UVicFormulaMotorsport/CANmon/hardware/documentation/models/c-1825910-7-c-3d.stp

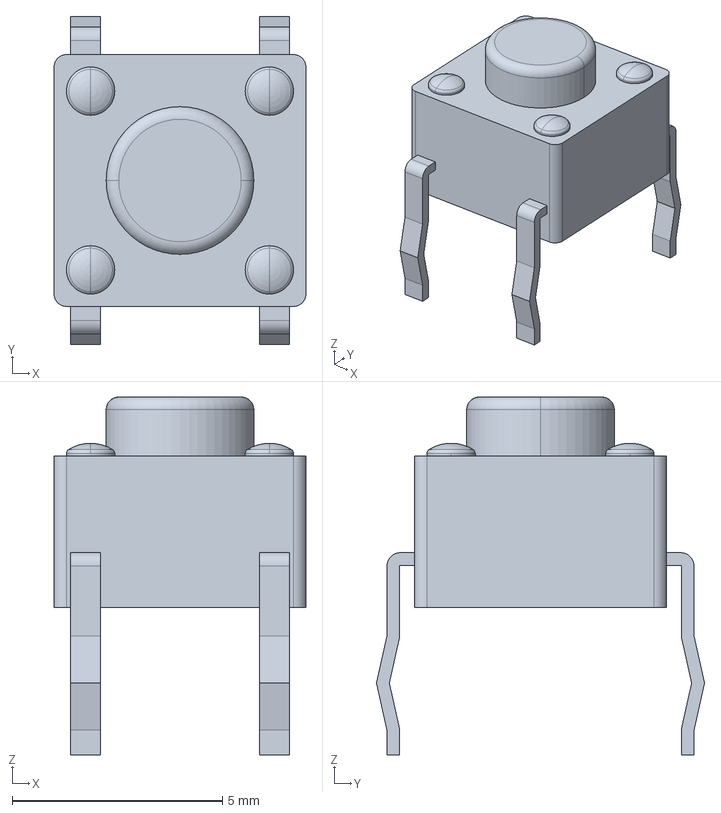
[picture p1: CAD file, 2016-02-04]
hardware/documentation/models/c-1825910-7-c-3d.stp
5.99 x 7.80 x 8.51 mm
