UVicFormulaMotorsport/CANmon/hardware/release/CANmon_Schematic.pdf

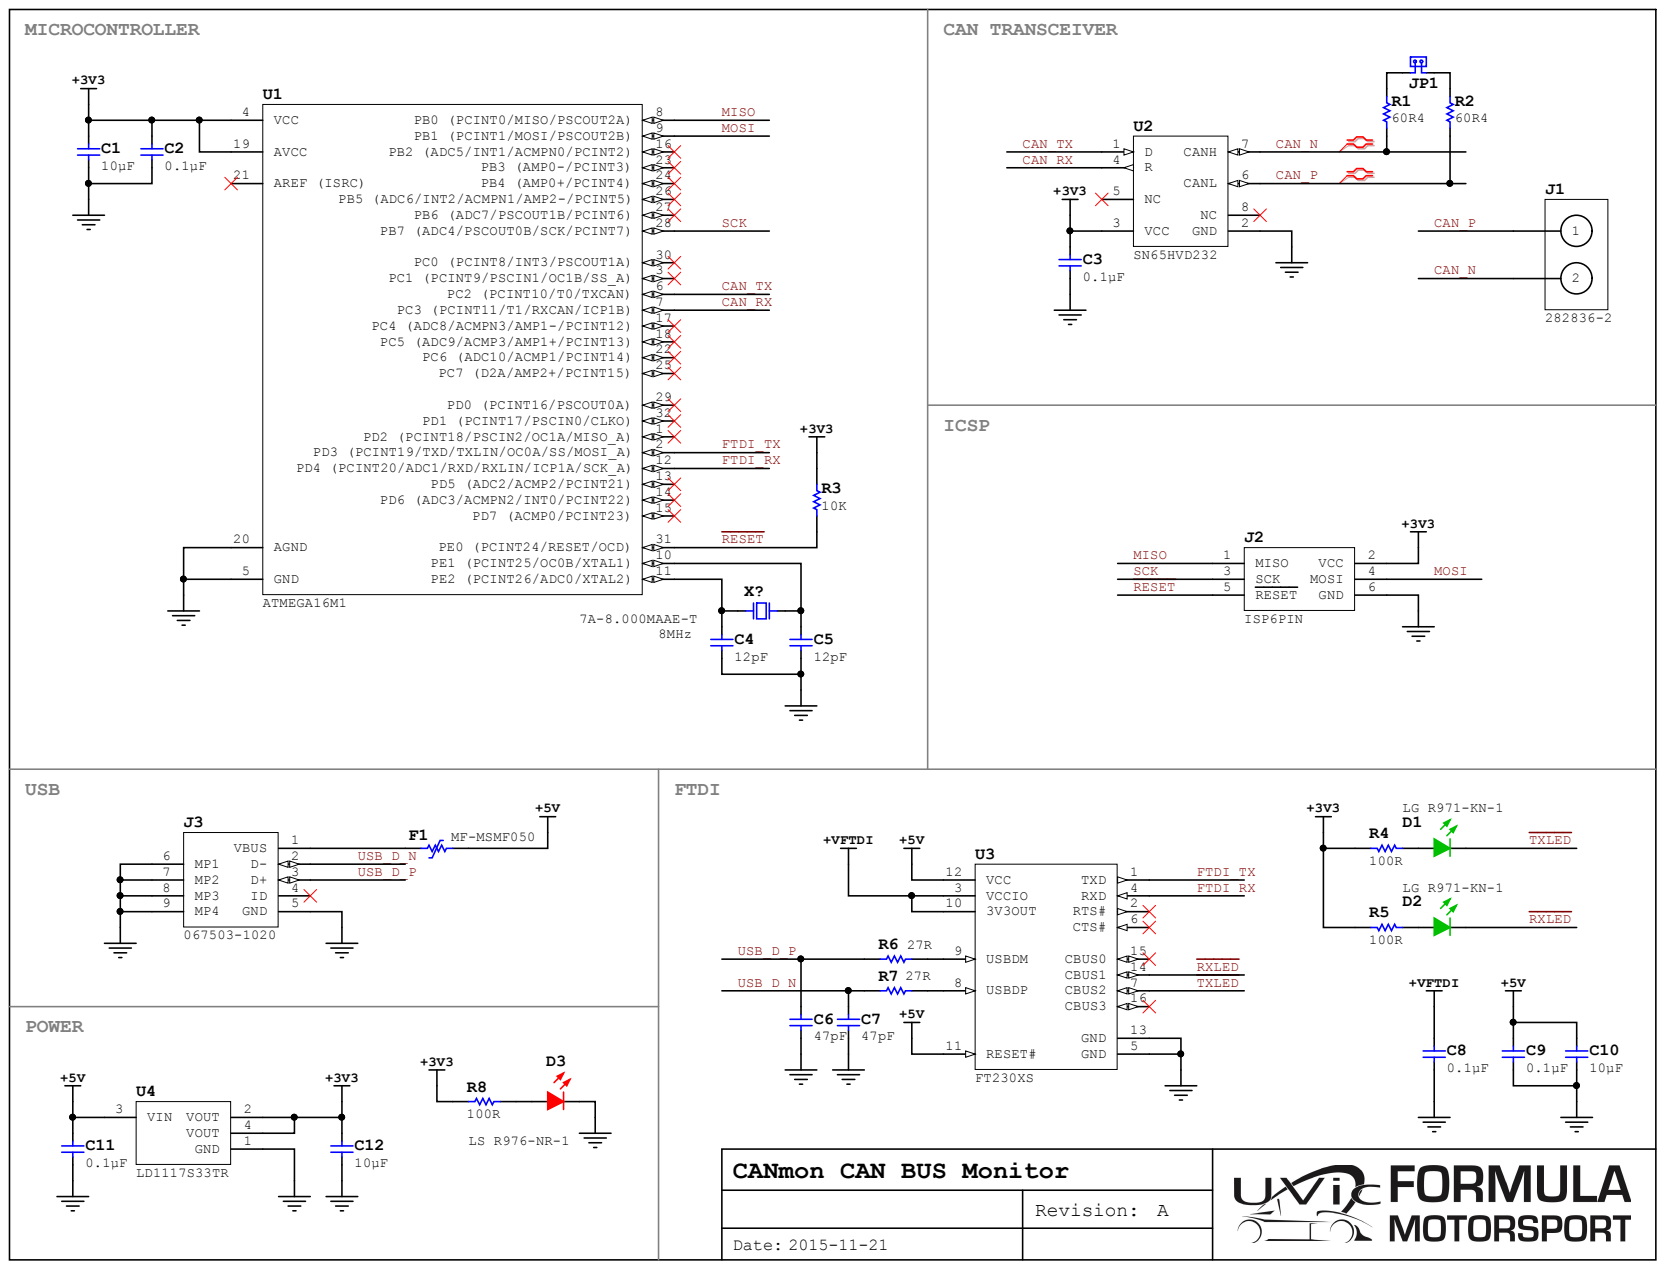
[picture p2: page 1]

CANmon CAN BUS Monitor

Revision: A

Date: 2015-11-21
