UVicFormulaMotorsport/CANmon/hardware/release/assembly/CANmon_Assembly.pdf

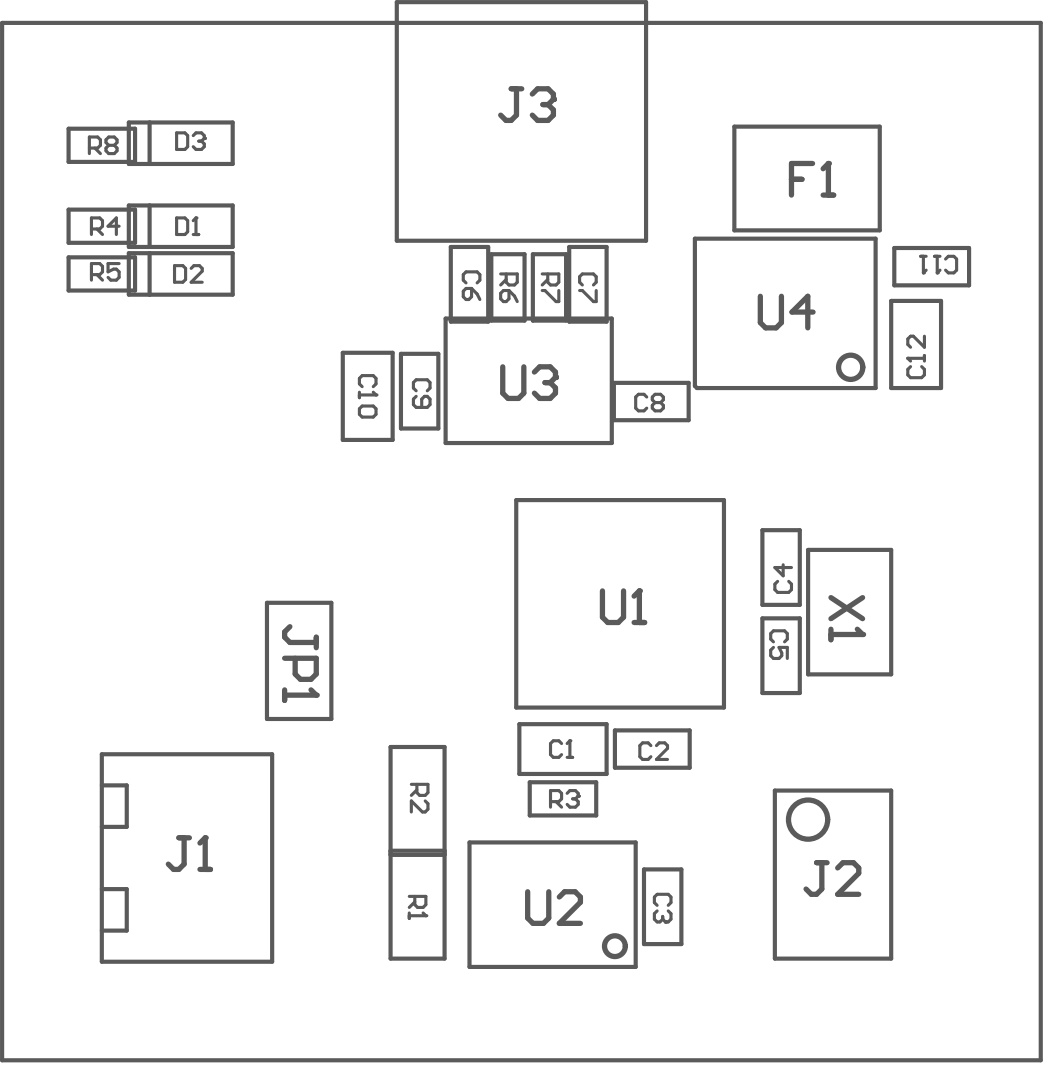
[picture p3: page 1]
