UVicFormulaMotorsport/CANmon/(list of files, drawings)

Other design files:
hardware/design/CANmon.PcbDoc
hardware/design/CANmon.PcbLib
hardware/design/CANmon.PrjPcb
hardware/design/CANmon.SchDoc
hardware/design/CANmon.SchLib
