UVicFormulaMotorsport/CANmon/(commit log)

2015-07-11 Imported rev0 hardware
    [CANmon.PcbDoc, CANmon.PcbLib, CANmon.PrjPcb, CANmon.SchDoc, CANmon.SchLib, CANmon_BOM.xls]
2015-07-11 Initial UART testing on ATmega2560
2015-07-12 Implemented simple interrupt-driven ring-buffered UART
2015-07-13 Slightly improved UART error handling
    [cm_uart.c, cm_uart.h]
2015-07-18 Fix silly UART read byte handling error
    Check for E_UART_RX_BUF_EMPTY instead of byte being equal to 0. byte
    could be 0 at any time and this does not imply nothing was read from the
    UART.
    [canmon.c]
2015-07-24 Add additional component data sheets
    - STMicroelectronics LD1117 low-dropout voltage regulator
    - TXC 7A Series SMD crystal oscillator
    - OSRAM LG R971 0805 LED
    - OSRAM LS R976 0805 LED
    - Molex 67503-1020 USB Mini-B connector
    - TE 282836 terminal block connector
2015-08-05 Fix corrupted BOM
    Altium or git messed this up big time.
    [CANmon.PrjPcb, CANmon_BOM.csv, CANmon_BOM.xls]
2015-11-21 hardware: Template and format update
    [CANmon.PcbDoc, CANmon.PrjPcb, CANmon.SchDoc, CANmon.SchLib]
2015-11-21 hardware: Replace 16 MHz crystal with 8 MHz
    At 3.3 V, the ATmega16M1 is limited to 8 MHz.
    [CANmon.SchDoc, CANmon.SchLib]
2016-02-04 hardware: Revision 2
    First: corrected stupid mistakes from the first revision. Note to
    anyone reading this: have someone else look over your schematics and
    double-check your pinouts.
    Second: completely revised the PCB layout.
    Third: added four user LEDs and four user buttons. The intention here
    is to allow a user to use the buttons to trigger message sennds and
    light the LEDs based on messages.
    Finally: updated some, but not all, of the passives to use my Altium
    libraries. I'll maybe do the rest at some point?
    [CANmon.PcbDoc, CANmon.PcbLib, CANmon.PrjPcb, CANmon.SchDoc, CANmon.SchLib, c-1825910-7-c-3d.stp]
